tmolteno/radio_module/hardware/tart_box/tart_box2.FCStd

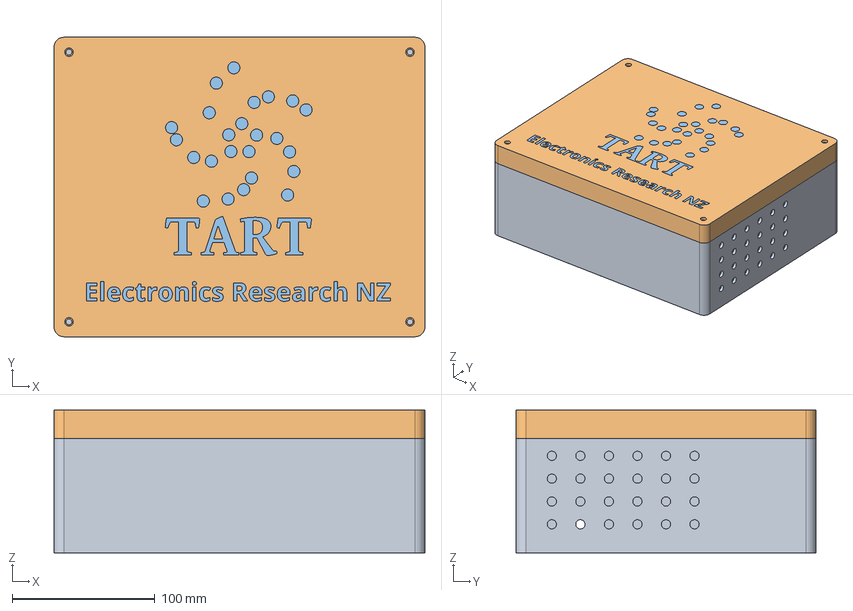
[picture p1: CAD file, 2026-01-24]
hardware/tart_box/tart_box2.FCStd
260.0 x 210.0 x 100.0 mm
LowerBody
BoxLid
TextSolid
