tmolteno/radio_module/hardware/tart_box/back-plate.FCStd

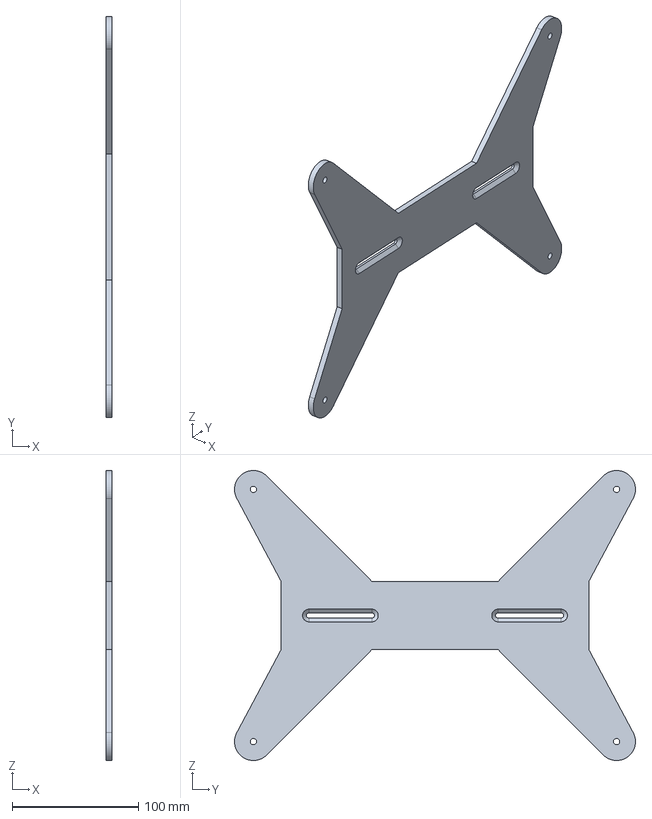
[picture p2: CAD file, 2025-05-09]
hardware/tart_box/back-plate.FCStd
5.00 x 318.0 x 230.0 mm
