tmolteno/radio_module/hardware/tart_box/tart_box.FCStd

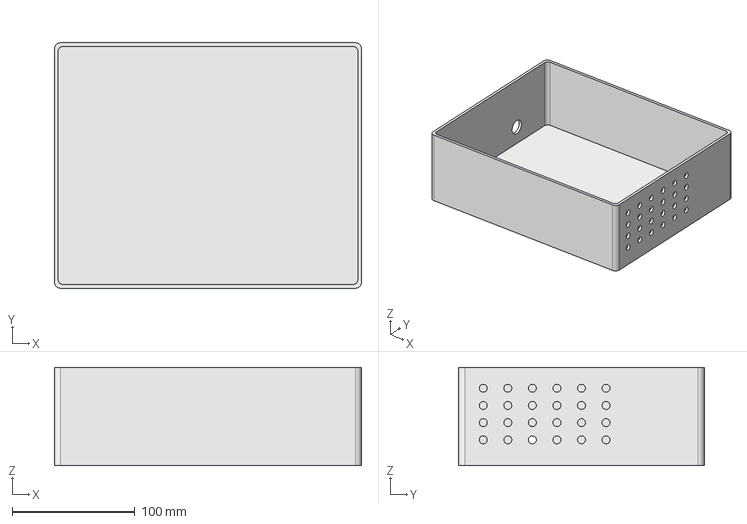
[picture p3: CAD file, 2024-09-03]
hardware/tart_box/tart_box.FCStd
250.0 x 200.0 x 80.0 mm
