tmolteno/radio_module/(commit log)

2024-08-09 Added an U.FL radio
    [radio.kicad_sch, ufl_radio.kicad_pcb, ufl_radio.kicad_sch]
2024-08-11 Slight cleanup
    [radio.kicad_sch, ufl_radio.kicad_pcb]
2024-09-02 Added the beginnings of a box
    [tart_box.FCStd]
2024-09-03 Updated the box
    [tart_box.FCStd]
2024-09-25 TART box 2 added
    [tart_box2.FCStd]
2024-10-01 Update box
    [tart_box2.FCStd]
2024-10-05 Add a lid and lid pocket
    [tart_box2.FCStd]
2024-10-06 Update and add a standoff for the rpi
    [standoff.scad]
2024-10-06 Indent the lid a little more
    [tart_box2.FCStd]
2024-10-09 Add text and font
    [tart_box2.FCStd]
2024-10-11 Add embossed text
    [tart_box2.FCStd]
2025-02-01 Change power hole. Through holes
2025-02-05 Added hole plug
    [hole_plug.scad]
2025-05-09 Added back plate
    [back-plate.FCStd]
2025-05-09 Added new power connector
2025-05-30 Move to kicad 9. Add panelization script and basic instructions
    [radio.kicad_sch, ufl_radio.kicad_pcb, ufl_radio.kicad_sch]
2025-07-28 Update to kicad 9
    [correlator.kicad_sch, psu.kicad_sch, spartan6.kicad_sch, spartan6_correlator.kicad_pcb, spartan6_correlator.kicad_sch]
2025-08-09 Added much more
    [psu.kicad_sch, spartan6.kicad_sch, spartan6_correlator.kicad_sch]
2025-08-09 Add USB JTAG and FLASH
    [spartan6.kicad_sch, spartan6_correlator.kicad_sch, usb_jtag.kicad_sch]
2025-08-09 Updates. Lots of them
    [correlator.kicad_sch, psu.kicad_sch, spartan6.kicad_sch, spartan6_correlator.kicad_pcb, usb_jtag.kicad_sch]
2025-08-09 Fix SDRAM to correct model
    [correlator.kicad_sch, psu.kicad_sch, spartan6.kicad_sch, spartan6_correlator.kicad_pcb, usb_jtag.kicad_sch]
2025-08-09 Update to remove USB jtag and use jtag-connect-6
    [spartan6.kicad_sch, spartan6_correlator.kicad_pcb, spartan6_correlator.kicad_sch]
2025-08-10 Clean up and get closer
    [psu.kicad_sch, spartan6.kicad_sch, spartan6_correlator.kicad_pcb]
2025-08-10 Started wiring up the radio
    [correlator.kicad_sch, spartan6.kicad_sch, spartan6_correlator.kicad_pcb]
2025-08-10 Finished wiring. Still to check
    [spartan6.kicad_sch]
2025-08-11 Onto the board
    [psu.kicad_sch, spartan6.kicad_sch, spartan6_correlator.kicad_pcb]
2025-08-12 Update the wiring
    [spartan6_correlator.kicad_pcb]
2025-08-12 First draft of board
    [spartan6_correlator.kicad_pcb]
2025-08-14 Latest version
    [psu.kicad_sch, spartan6.kicad_sch, spartan6_correlator.kicad_pcb]
2025-08-26 Pull M0 to VCC
    [spartan6.kicad_sch, spartan6_correlator.kicad_pcb]
2025-08-26 Add JTAG header as last resort
    [spartan6.kicad_sch, spartan6_correlator.kicad_pcb]
2025-08-31 Update correlator
    [spartan6.kicad_sch, spartan6_correlator.kicad_pcb]
2025-11-25 Slightly increase antenna SMA connector spacing
2025-11-26 Updated the order of radios
    [ufl_radio.kicad_pcb]
2025-11-26 Minor updates
    [ufl_radio.kicad_pcb]
2025-11-27 Added radio board with identical sections
    [ufl_radio.kicad_pcb]
2025-11-27 DRC passing mostly
    [ufl_radio.kicad_pcb]
2025-11-29 Nearly ready
    [radio.kicad_sch, ufl_radio.kicad_pcb]
2025-11-30 Replace the RS485 driver as it is no longer in production
    [ufl_radio.kicad_pcb, ufl_radio.kicad_sch]
2025-12-01 Add a better panelize script and get the impedance right
    [ufl_radio.kicad_pcb]
2025-12-02 Fix up ground rules
    [radio.kicad_sch, ufl_radio.kicad_pcb]
2025-12-11 Update and improve noise on ufl radio
    [radio.kicad_sch, ufl_radio.kicad_pcb]
2026-01-24 Box updates
    [tart_box2.FCStd]
2026-03-03 Update to new DFN8 package
    [ufl_radio.kicad_pcb, ufl_radio.kicad_sch]
2026-04-20 Update to KiCAD 10
    [correlator.kicad_sch, mcu.kicad_sch, motherboard.kicad_pcb, motherboard.kicad_sch, power.kicad_sch, psu.kicad_sch, radio.kicad_sch, radio_bank.kicad_sch]
2026-08-26 add impedance matching resistors to RS485
    [motherboard.kicad_pcb, motherboard.kicad_sch]
