tmolteno/radio_module/(notices)

Notices in the files:
hardware/correlator_to_papilio/correlator_to_papilio.kicad_sch:
Copyright (c) Tim Molteno 2024
hardware/motherboard/motherboard.kicad_pcb:
(c) 2023
GPL v3.0, July 2026
